bveenema/ArduinoExamples/PCB/Spec Hours.txt

2/7/18 - 3.1 hours (PCB)
2/10/18 - 4 hours (PCB)
