bveenema/ArduinoExamples/ReadmeAssets/DownloadZip.jpg

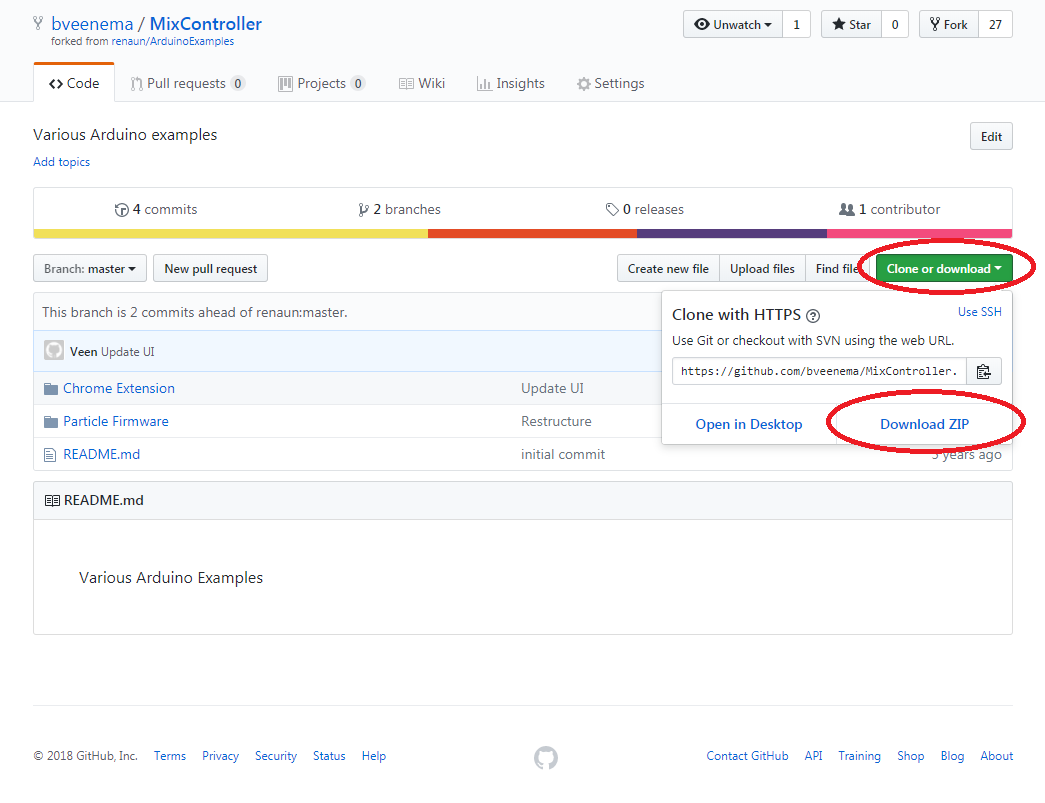
ReadmeAssets/DownloadZip.jpg
