bveenema/ArduinoExamples/ReadmeAssets/LoadUnpackedExtension.jpg

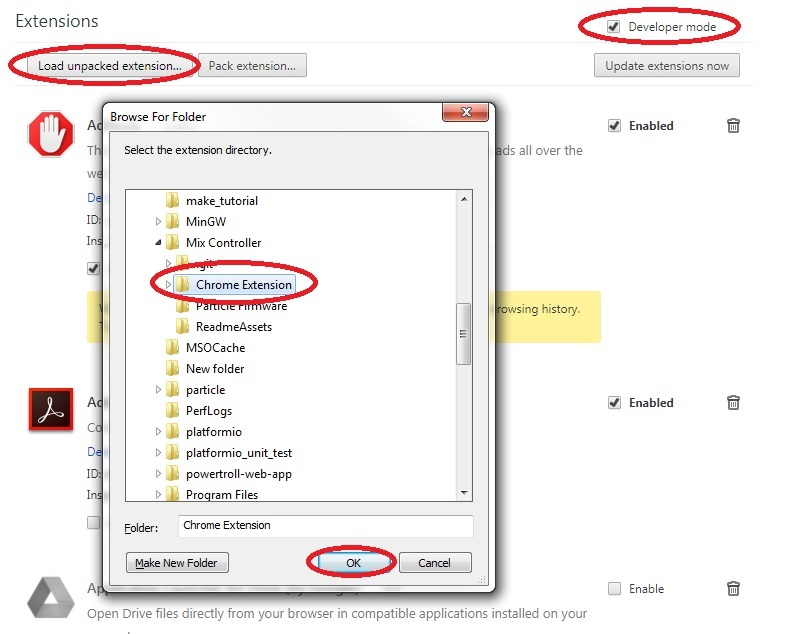
ReadmeAssets/LoadUnpackedExtension.jpg
