bveenema/ArduinoExamples/ReadmeAssets/MixControllerExtension.jpg

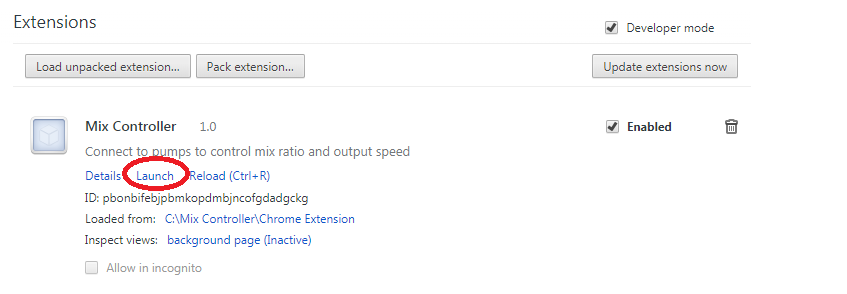
ReadmeAssets/MixControllerExtension.jpg
