bveenema/ArduinoExamples/Particle Firmware/SW Flow Chart.pdf

# ECM Software Flow Diagram

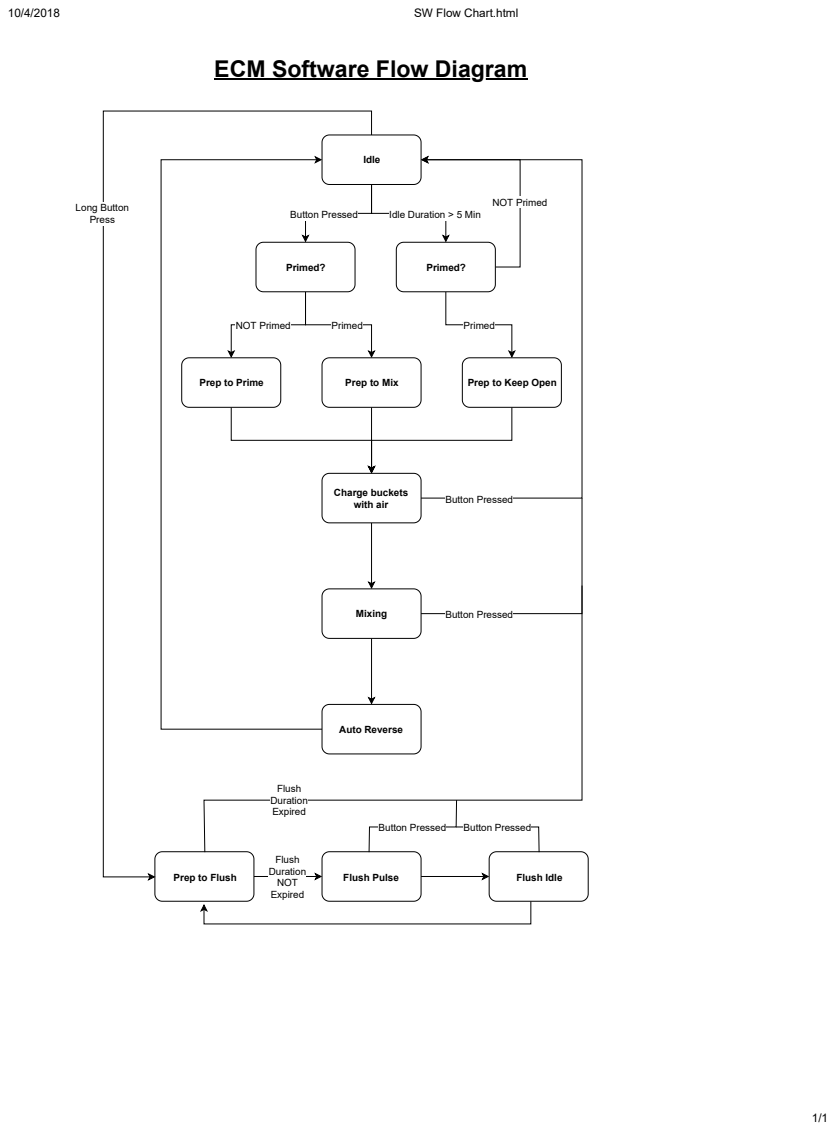
[picture p17: page 1]
SW Flow Chart.html; Button Pressed; Idle Duration > 5 Min; Idle; NOT Primed; Primed; Primed?; Charge buckets with air; Mixing; Auto Reverse; Prep to Prime; Prep to Mix; Flush Duration NOT Expired; Prep to Flush; Flush Pulse; Flush Idle; Long Button Press; Flush Duration Expired

Prep to Keep Open
