bveenema/ArduinoExamples/PCB/MixController.kicad_pcb

## KiCad design PCB/MixController.kicad_pcb (2018-11-07)

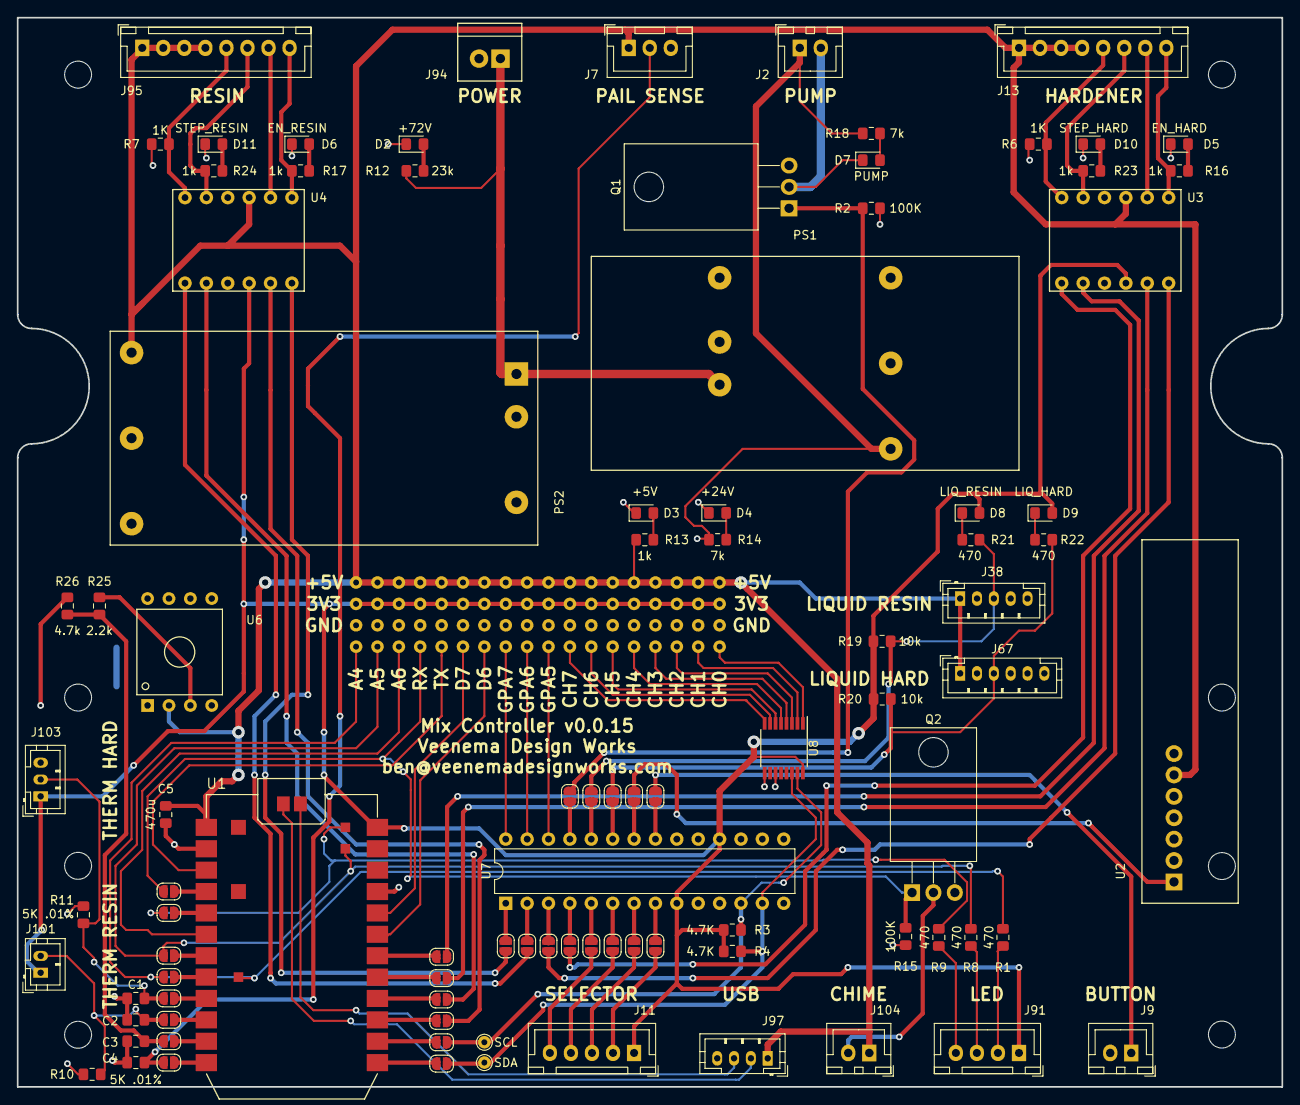
[picture p18: board MixController.kicad_pcb from above]

Board: 2 copper layers, 150.2 x 127.0 mm, 166 parts (0 on the bottom side), 100 nets.

Parts:
C1, C2, C3, C4: 0.1u; C_0805_2012Metric_Pad1.15x1.40mm_HandSolder
C5: 470u; C_0805_2012Metric_Pad1.15x1.40mm_HandSolder
D2: +72V; LED_0805_2012Metric_Pad1.15x1.40mm_HandSolder
D3: +5V; LED_0805_2012Metric_Pad1.15x1.40mm_HandSolder
D4: +24V; LED_0805_2012Metric_Pad1.15x1.40mm_HandSolder
D5: EN_HARD; LED_0805_2012Metric_Pad1.15x1.40mm_HandSolder
D6: EN_RESIN; LED_0805_2012Metric_Pad1.15x1.40mm_HandSolder
D7: PUMP; LED_0805_2012Metric_Pad1.15x1.40mm_HandSolder
D8: LIQ_RESIN; LED_0805_2012Metric_Pad1.15x1.40mm_HandSolder
D9: LIQ_HARD; LED_0805_2012Metric_Pad1.15x1.40mm_HandSolder
D10: STEP_HARD; LED_0805_2012Metric_Pad1.15x1.40mm_HandSolder
D11: STEP_RESIN; LED_0805_2012Metric_Pad1.15x1.40mm_HandSolder
J2, J9, J104: B2B-XH-A(LF)(SN); JST_XH_B02B-XH-A_1x02_P2.50mm_Vertical
J7: B3B-XH-A(LF)(SN); JST_XH_B03B-XH-A_1x03_P2.50mm_Vertical
J11: B5B-XH-A(LF)(SN); JST_XH_B05B-XH-A_1x05_P2.50mm_Vertical
J13, J95: B8B-XH-A(LF)(SN); JST_XH_B08B-XH-A_1x08_P2.50mm_Vertical
J15, J16, J17, J18, J19, J20, J21, J22, J23, J24, J25, J26, J27, J28, J29, J30, J31, J32, J33, J34, J35, J36, J37, J39, J40, J41, J42, J43, J44, J45, J46, J47, J48, J49, J50, J51, J52, J53, J54, J56, J57, J58, J59, J60, J61, J62, J63, J64, J65, J66, J68, J69, J70, J72, J73, J74, J75, J76, J77, J78, J79, J80, J81, J82, J83, J84, J85, J86, J87, J88, J89, J90: ConnectorPoint_THT_D1.5mm_Drill-0.7mm
J38: B5B-PH-K-S(LF)(SN); JST_PH_B5B-PH-K_1x05_P2.00mm_Vertical
J67: B6B-PH-K-S(LF)(SN); JST_PH_B6B-PH-K_1x06_P2.00mm_Vertical
J91: B4B-XH-A(LF)(SN); JST_XH_B04B-XH-A_1x04_P2.50mm_Vertical
J94: 0705430001; Molex-705430001_02x2.54mm_Straight
J97: B4B-PH-K-S(LF)(SN); JST_PH_B4B-PH-K_1x04_P2.00mm_Vertical
J101: B2B-PH-K-S(LF)(SN); JST_PH_B2B-PH-K_1x02_P2.00mm_Vertical
J103: B3B-PH-K-S(LF)(SN); JST_PH_B3B-PH-K_1x03_P2.00mm_Vertical
JP1, JP2, JP3, JP4, JP5, JP6, JP7, JP8, JP9, JP10, JP11, JP12, JP13, JP14, JP15, JP16, JP17, JP18, JP19, JP20, JP21, JP22, JP23, JP24, JP25, JP26, JP27: SolderJumper-2_P1.3mm_Open_RoundedPad1.0x1.5mm
PS1: ERM01H110
PS2: RSDW20H-05; RSDW20_H
Q1, Q2: Q_NMOS_GDS; TO-220-3_Horizontal_TabDown
R1, R8, R9, R21, R22: 470; R_0805_2012Metric_Pad1.15x1.40mm_HandSolder
R2, R15: 100K; R_0805_2012Metric_Pad1.15x1.40mm_HandSolder
R3, R4: 4.7K; R_0805_2012Metric_Pad1.15x1.40mm_HandSolder
R6, R7: 1K; R_0805_2012Metric_Pad1.15x1.40mm_HandSolder
R10, R11: 5K .01%; R_0805_2012Metric_Pad1.15x1.40mm_HandSolder
R12: 23k; R_0805_2012Metric_Pad1.15x1.40mm_HandSolder
R13, R16, R17, R23, R24: 1k; R_0805_2012Metric_Pad1.15x1.40mm_HandSolder
R14, R18: 7k; R_0805_2012Metric_Pad1.15x1.40mm_HandSolder
R19, R20: 10k; R_0805_2012Metric_Pad1.15x1.40mm_HandSolder
R25: 2.2k; R_0805_2012Metric_Pad1.15x1.40mm_HandSolder
R26: 4.7k; R_0805_2012Metric_Pad1.15x1.40mm_HandSolder
TP1: SCL; TestPoint_THTPad_D1.5mm_Drill0.7mm
TP2: SDA; TestPoint_THTPad_D1.5mm_Drill0.7mm
U1: Photon; photon_smd
U2: Adafruit_1096; SimpleRF_Receiver
U3, U4: BOB-12009; BOB-12_W10.16mm
U6: HSCDANN005PGAA5; HoneyWell_DIP_AN
U7: MCP23017_SP; DIP-28_W7.62mm
U8: ADS7830; TSSOP-16_4.4x5mm_P0.65mm

Connections:
+3V3: D8.2, D9.2, J11.1, J20.1, J21.1, J22.1, J23.1, J24.1, J47.1, J48.1, J49.1, J50.1, J51.1, J52.1, J53.1, J54.1, J56.1, J57.1, J58.1, J87.1, J88.1, J91.1, J101.1, J103.1, R3.1, R4.1, R19.1, R20.1, U1.24, U3.4, U4.4, U7.9, U7.18, U8.16
+5V: C5.2, J7.1, J13.1, J13.2, J13.3, J13.4, J15.1, J16.1, J17.1, J18.1, J19.1, J30.1, J31.1, J32.1, J33.1, J34.1, J35.1, J36.1, J37.1, J38.1, J39.1, J40.1, J41.1, J67.1, J89.1, J90.1, J95.1, J95.2, J95.3, J95.4, J97.1, J104.1, PS2.3, R13.1, U1.1, U2.6, U3.9, U4.9, U6.2
+24V: J2.1, PS1.4, R14.2, R18.2
+72V: J94.1, PS1.1, PS2.1, R12.2
/CHIME: J43.1, JP26.1, Q2.1, R15.1
/HARDENER_ENABLE: JP8.1, U3.6
/HARDENER_HLFB: JP9.1, U3.1
/HARDENER_INPUT_DIR: JP19.2, U3.5
/HARDENER_INPUT_STEP: JP18.2, U3.2
/LIQUID_SNS_HARDENER: J67.3, JP16.1, R20.2, R22.1
/LIQUID_SNS_RESIN: J38.3, JP17.1, R19.2, R21.1
/PAIL_SNS: C4.2, J7.2, JP5.1
/PRESS_SNS: C3.2, JP4.1, R25.2, R26.1
/PUMP_EN: JP27.1, Q1.1, R2.1
/RESIN_ENABLE: JP6.1, U4.6
/RESIN_HLFB: JP7.1, U4.1
/RESIN_INPUT_DIR: JP21.2, U4.5
/RESIN_INPUT_STEP: JP20.2, U4.2
/ROTARY_1: J11.2, JP13.1
/ROTARY_2: J11.3, JP12.1
/ROTARY_3: J11.4, JP11.1
/ROTARY_4: J11.5, JP10.1
/SCL: JP22.2, R3.2, TP1.1, U7.12, U8.15
/SDA: JP23.2, R4.2, TP2.1, U7.13, U8.14
/STATUS_LED_B: JP1.1, R9.1, U1.29
/STATUS_LED_G: J45.1, JP2.1, R8.1, U1.28
/STATUS_LED_R: J46.1, JP3.1, R1.1, U1.27
/THERM_HARDENER: C1.2, J103.2, JP24.1, R11.1
/THERM_RESIN: C2.2, J101.2, JP25.1, R10.1
/USB(+): J97.2, U1.31
/USB(-): J97.3, U1.30
/USER_BUTTON: J9.1, JP14.1
/USER_REMOTE: JP15.1, U2.1
GND: C1.1, C2.1, C3.1, C4.1, C5.1, D2.1, D3.1, D4.1, D5.1, D6.1, D10.1, D11.1, J7.3, J9.2, J25.1, J26.1, J27.1, J28.1, J29.1, J38.2, J38.4, J59.1, J60.1, J61.1, J62.1, J63.1, J64.1, J65.1, J66.1, J67.2, J67.4, J68.1, J69.1, J70.1, J85.1, J86.1, J94.2, J97.4, PS1.2, PS1.6, PS2.2, PS2.5, Q1.3, Q2.3, R2.2, R6.1, R7.1, R10.2, R11.2, R15.2, R26.2, U1.2, U1.21, U2.7, U3.3, U3.10, U4.3, U4.10, U6.4, U7.10, U8.9, U8.11
unnamed: D2.2, R12.1
unnamed: D3.2, R13.2
unnamed: D4.2, R14.1
unnamed: D5.2, R16.2
unnamed: D6.2, R17.2
unnamed: D7.1, J2.2, Q1.2
unnamed: D7.2, R18.1
unnamed: D8.1, R21.2
unnamed: D9.1, R22.2
unnamed: D10.2, R23.2
unnamed: D11.2, R24.2
unnamed: J13.5, R6.2, U3.12
unnamed: J13.6, R23.1, U3.11
unnamed: J13.7, U3.8
unnamed: J13.8, R16.1, U3.7
unnamed: J42.1, U1.3
unnamed: J44.1, U1.6
unnamed: J72.1, U7.26
unnamed: J73.1, U7.27
unnamed: J74.1, U7.28
unnamed: J75.1, U8.1
unnamed: J76.1, U8.2
unnamed: J77.1, U8.3
unnamed: J78.1, U8.4
unnamed: J79.1, U8.5
unnamed: J80.1, U8.6
unnamed: J81.1, U8.7
unnamed: J82.1, U8.8
unnamed: J83.1, U1.20
unnamed: J84.1, U1.19
unnamed: J91.2, R1.2
unnamed: J91.3, R8.2
unnamed: J91.4, R9.2
unnamed: J95.5, R7.2, U4.12
unnamed: J95.6, R24.1, U4.11
unnamed: J95.7, U4.8
unnamed: J95.8, R17.1, U4.7
unnamed: J104.2, Q2.2
unnamed: JP1.2, U1.5
unnamed: JP2.2, U1.7
unnamed: JP3.2, U1.8
unnamed: JP4.2, U1.11
unnamed: JP5.2, U1.12
unnamed: JP6.2, U7.1
unnamed: JP7.2, U7.2
unnamed: JP8.2, U7.3
unnamed: JP9.2, U7.4
unnamed: JP10.2, U7.5
unnamed: JP11.2, U7.6
unnamed: JP12.2, U7.7
unnamed: JP13.2, U7.8
unnamed: JP14.2, U7.21
unnamed: JP15.2, U7.22
unnamed: JP16.2, U7.23
unnamed: JP17.2, U7.24
unnamed: JP18.1, U1.18
unnamed: JP19.1, U1.17
unnamed: JP20.1, U1.16
unnamed: JP21.1, U1.15
unnamed: JP22.1, U1.14
unnamed: JP23.1, U1.13
unnamed: JP24.2, U1.9
unnamed: JP25.2, U1.10
unnamed: JP26.2, U1.4
unnamed: JP27.2, U7.25
unnamed: R25.1, U6.3
