bveenema/ArduinoExamples/Particle Firmware/src/globals.h

#ifndef GLOBALS_H
#define GLOBALS_H


#include "Particle.h"
#include "config.h"
#include <Adafruit_MCP23017.h>

// MCP23017
extern Adafruit_MCP23017 IOExp;

// Prime Info
extern bool isPrimed;

// Wifi Status
extern uint32_t wifiStatus;

// Error Status
extern char currentError[30];

// Selector
extern int selector;

// State Machine
extern bool changeState;

// Settings
extern prom_settings settings;

extern bool FLAG_wasError;
extern bool FLAG_justReset;

// Debugging Variables
extern uint32_t debug_incrementer;

#endif
