bveenema/ArduinoExamples/(commit log)

2018-03-11 Added Motor B and Error LED
    [MixController.ino]
2018-03-12 Flipped STEP and DIR pins
    [MixController.ino]
2018-03-12 removed Internal pullup on button (using external 10k)
    [Stepper Calculator.xlsx]
2018-03-20 Added button debounce and reversed dir pin
    [MixController.ino]
2018-04-02 Removed AutoReverse and Error Handling
    [MixController.ino]
2018-04-19 Added Schematic
    [MixController.kicad_pcb, MixController.sch]
2018-04-19 Create PDF of Schematic
2018-04-20 Removed extra Timer calls
2018-05-01 Change to AC/DC converter from USB wall wort
    [MixController.sch]
2018-05-14 Change to toggle button function
2018-05-18 Fix wire colors
    [MixController.sch]
2018-05-20 Updated Schematic
2018-07-03 save all stashed
    [MixController.sch]
2018-07-03 Add Radio and Level Translator
    [MixController.sch]
2018-07-18 Add Level Translators and box image
    [MixController.sch]
2018-07-18 Disable motors when not in use
2018-08-09 Add autoreverse, toggle pumps button and update to version 0.0.4
2018-08-23 Remove Switch and Relay, add Battery Connector
    [MixController.sch]
2018-08-28 Add Serial prints for button presses
2018-08-29 Fix selector variable name error
    [MixController.ino]
2018-08-29 Fix flag not clearing when no selector bug
    [MixController.ino]
2018-08-30 Fix selector switch detection
    [MixController.ino]
2018-08-30 Fix motorSettings not loading from EEPROM
    [MixController.ino]
2018-08-30 Add kicad backup file
2018-08-30 Add cable notes
    [MixController.sch]
2018-08-30 Add Rotary Selector
    [MixController.sch]
2018-08-30 Fix divide by 0 error when both motor ratios are 0 or flowRate is 0
    [MixController.ino]
2018-09-15 Update schematic with photo of selector
    [MixController-2018-09-15-11-00-13.sch]
2018-09-16 Prep for v0.0.6
    [MixController.sch]
2018-09-22 Create v0.0.7 schematic
    [MixController.csv, MixController.sch]
2018-09-22 Create Pneumatics Schematic
    [ECM-Pneumatics.sch]
2018-09-23 Remove motor specific variables from globals
2018-09-23 Rename all "motor" to "pump"
2018-09-23 Cleaning runs at "correct" ratio
    [MixMaster.cpp]
2018-09-23 Create Pressure Manager
2018-09-23 Add Charging state to mixerState
2018-09-23 Add error checking for pumps
    [MixMaster.cpp, MixMaster.h]
2018-09-23 Change "Motor Error" to "Pump Error"
    [MixMaster.cpp]
2018-09-23 Add Status LED module
2018-09-23 Add 'chargePressure', 'flushVolume' and 'startCleaning' commands
2018-09-24 Fix cleaning by default bug
    [MixController.ino]
2018-09-24 Fix bugs with MixMaster state
    [MixMaster.cpp, MixMaster.h, config.h]
2018-09-24 switch from 'name' to 'id' identification of commands
2018-09-24 Add chargPressure command
2018-09-24 Change the way action-buttons are handled
2018-09-27 Update connectors
    [MixController.sch]
2018-09-27 Swap D6 and D7 pins
    [MixMaster.cpp, config.h]
2018-09-27 Add current pressure output
2018-09-27 action-button disabling/enabling
2018-09-27 Add Dual State Button
2018-09-27 Fix Pressure Calculation
2018-09-27 Fix Long Press Remote on Startup (not in socket)
    [MixController.ino]
2018-09-27 Fix charging state
2018-09-27 Move Flow Rate and Volume to slider settings
2018-09-27 Create Pail Sensor
2018-09-27 Reduce max volume to 10,000ml (2.5 gallons)
2018-09-28 Update wire lengths
    [_saved_MixController.sch]
2018-09-28 Disable error checking on pumps
    [MixMaster.cpp]
2018-09-29 Add 470 PD resistor to HV4 Inputs - Fix Pump Error
    [MixController.sch]
2018-09-29 Fix not updating detection threshold before restart
    [AppInterface.h]
2018-09-29 Fix: Pail Sensor not stopping mixing/keep open
    [MixMaster.cpp]
2018-09-29 Enable pump error checking
    [MixMaster.cpp]
2018-09-29 Fix: Flushing was only working first cycle
    [MixMaster.cpp]
2018-09-29 Remove unneeded serial prints
2018-09-29 100 sample rolling average
2018-09-29 Remove voltage divider on pail sensor output
    [MixController.sch]
2018-09-30 Fix: Pump error detection
    [MixMaster.cpp, config.h]
2018-10-01 Add 10ms delay between pressure reads
2018-10-01 Add min charging time
2018-10-01 Kill cycle if NOT charged for longer than settings.maxNoPressure
2018-10-02 Add pail sensor error checking
    [MixMaster.cpp]
2018-10-02 Prevent charging error when flushing
    [MixMaster.cpp]
2018-10-02 Pressure Pump Always On
2018-10-02 Enable wifi if button long pressed 3 times
2018-10-05 Add I/O and ADC Expanders
    [MixController.sch]
2018-10-07 Add footprints, Add connector between cable power and board
    [MixController.sch]
2018-10-08 Start Layout
    [MixController.sch]
2018-10-09 Continue Layout
    [MixController.kicad_pcb, MixController.sch]
2018-10-11 Add VDW-Kicad-Symbols
2018-10-11 Add knob note
    [MixController.sch]
2018-10-11 Update Libraries
    [MixController.sch]
2018-10-11 Remove backup
    [MixController-2018-09-15-11-00-13.sch]
2018-10-12 Update Board Profile
    [MixController.kicad_pcb]
2018-10-12 Update PCB Layout
    [MixController.kicad_pcb]
2018-10-13 Switch to 200 steps/rev pump setting. Pump update called 10us interval
2018-10-13 Disable incrementer for pump update
2018-10-13 Make PressureManager self declaring and including
2018-10-13 Move initial target pressure from constructor to init
2018-10-13 Enable charge pressure udpate via app
2018-10-15 Switch to 200 steps/rev motor setting. Pump stops while charging
2018-10-15 Add temporary voltage divider
    [MixController.sch]
2018-10-15 Change from target pressure to pressure window for charging
2018-10-16 Add app interface for Charging Timeout and Cool Down
2018-10-16 Add charging timeout and cooldown
2018-10-16 Fix typo {} was ()
    [AppInterface.h]
2018-10-22 Disabel PRESSURE_ALWAYS_ON
2018-10-22 Make chargeDelay user settable
2018-10-23 Remove chargeCoolDown, replace with chargeOffTime
    [AppInterface.h, config.h]
2018-10-23 Remove Charge Cool-Down Feature
2018-10-23 Remove minChargingTime, replace with maxPreMixChargingTime
    [AppInterface.h, MixMaster.cpp, config.h]
2018-10-23 Keep chargeTimeout variable name, change app wording to Charge Time
2018-10-23 Regress to chargeTime and chargeOffTime functioning
2018-10-23 rename app variables, increase max charge time to 60000
2018-10-23 disable pump if charging not allowed
2018-10-24 Air pump off at beginning of wasCharging cycle
2018-10-25 Add delay after initial charge
2018-10-25 Fix mixing timer
2018-10-25 Change ON/OFF pressure to Low/High Pressure
2018-10-25 Add charging error time to spec
2018-10-25 Add unit for charging error time to spec
2018-10-29 Add indicator leds, chime speaker, update layout
    [MixController.kicad_pcb, MixController.sch]
2018-10-30 update schematic per ECN Maxx 5
    [MixController.kicad_pcb, MixController.sch]
2018-10-30 Update Layout
    [MixController.kicad_pcb, MixController.sch]
2018-10-30 Update Footprint Library
2018-10-31 Update commit to track
2018-10-31 Finalize layout for v0.0.15
    [MixController.kicad_pcb, MixController.sch]
2018-10-31 add *.kicad_pcb-bak
2018-10-31 Change offboard component footprint from '~' to 'NoFootprint'
    [MixController.kicad_pcb, MixController.sch]
2018-10-31 Change out submodules to track master
2018-10-31 update footprints
    [MixController.kicad_pcb, MixController.sch]
2018-11-01 Add Knob component, change to LED Rocker Switch
    [MixController.csv, MixController.sch]
2018-11-01 Capatalize "Remote" and "Button" objects
2018-11-02 Add FW pin numbers to MCP23017
    [MixController.sch]
2018-11-02 Switch to RGB LED
2018-11-02 Add 2 Red LEDs for Liquid Sensor status
2018-11-03 Add MCP address pin pull down resistors
    [MixController.sch]
2018-11-03 Create Liquid Sensor module
2018-11-03 Change selector switch to active low
    [MixController.sch]
2018-11-03 Move selector switch to IOExp
2018-11-04 Add TemperatureMonitor
2018-11-04 Remove pressure manager include
2018-11-04 Swap pin to IOExp
    [PressureManager.cpp]
2018-11-04 Move Button and Remote to IOExp
2018-11-04 Fix RedLED off when no error
    [StatusLED.h]
2018-11-05 Make SLOW chime for temperature range live
2018-11-05 Re-write Pressure Manager
2018-11-05 Add liquid sensor checking
2018-11-07 Fix Selector, update fixed resistor value
    [MixController.ino, MixMaster-MainState.cpp, config.h]
2018-11-07 add cabling notes
    [MixController.kicad_pcb, MixController.sch]
2018-11-09 Red LED off when liquid present and not mixing
2018-11-09 Update cable lengths, add notes about solder bridge and radio replace
    [MixController.sch]
2018-11-14 Fix temperature range not set on startup
    [MixController.ino]
2018-12-06 Consolidate Enabling/Disabling of Pumps to prevent excessive IOExp calls
    [MixMaster-Flush.cpp, MixMaster-HelperFuncs.cpp, MixMaster-MainState.cpp, MixMaster.cpp, MixMaster.h]
2018-12-09 Any button press in selector pos 0 initiates flush
2018-12-09 Change default flush reverse steps to 180
    [config.h]
2018-12-09 Prevent ZeroDrip while in Flush selector position (0)
    [MixMaster-MainState.cpp]
2018-12-09 Add delay after enabling pumps. Goal to allow shorter steps to function.
    [MixMaster-ZeroDrip.cpp]
2018-12-09 Add DFU Mode button to App
2018-12-09 Update Kicad Symbols Ref
2018-12-15 ZeroDrip runs regardless of bucket. Stops if KeepOpen stop due to bucket
2018-12-15 Update ZeroDrip prototype
2018-12-18 Add Camera Subsection
2018-12-24 Prevent KeepOpen and ZeroDrip while in flush selector position
    [MixMaster-MainState.cpp]
2019-02-01 Add inital air charge
2019-02-01 Add Interval Charging
2019-02-06 Add pump error detection and handling
    [MixMaster-MainState.cpp, config.h]
